Alex206/electric-kids-kart/docs/11_measurements_needed.md

# 11 — Measurements required before fabrication

Fill in every `TBD` field.

## Existing wheels

| Measurement | Front left | Front right | Rear left | Rear right |
|---|---:|---:|---:|---:|
| Outside diameter, mm | TBD | TBD | TBD | TBD |
| Width, mm | TBD | TBD | TBD | TBD |
| Hub bore / bearing ID, mm | TBD | TBD | TBD | TBD |
| Bolt circle and stud count | TBD | TBD | TBD | TBD |
| Offset from hub face, mm | TBD | TBD | TBD | TBD |
| Load/speed marking | TBD | TBD | TBD | TBD |

Photograph both sides of every wheel with a ruler in frame.

## Existing steel

| Field | Value |
|---|---|
| Profile shape | TBD |
| Outside dimensions | TBD |
| Wall thickness | TBD |
| Length and quantity | TBD |
| Material/grade if known | TBD |
| Rust, dents or prior welds | TBD |

## Driver fit

Measure seated in the intended kart posture, wearing shoes and helmet.

| Measurement | 5-year-old | 13-year-old | Adult tester |
|---|---:|---:|---:|
| Mass, kg | TBD | TBD | TBD |
| Hip-to-heel, mm | TBD | TBD | TBD |
| Hip-to-steering-wheel reach, mm | TBD | TBD | TBD |
| Shoulder height above seat, mm | TBD | TBD | TBD |
| Hip width, mm | TBD | TBD | TBD |

## Site

- Usable straight-line test distance: TBD m.
- Surface: TBD.
- Maximum gradient: TBD %.
- Minimum turning-area width: TBD m.
- Storage temperature range: TBD.

## Component interfaces after purchase

- Axle length and keyway: TBD.
- Hub bolt pattern: TBD.
- Brake disc diameter/thickness/bolt circle: TBD.
- Spindle kingpin diameter and steering arm thread: TBD.
- Motor shaft/sprocket dimensions: TBD.
- Battery exact dimensions, mass and connector: TBD.
