Alex206/electric-kids-kart/CHANGELOG.md

# Changelog

## 0.1.0 — 2026-08-01

- Initial requirements, safety concept and architecture.
- Parametric frame model and preliminary drawings.
- Two-stage MY1020D drivetrain calculation.
- BOM and current price references for Germany/EU.
- VESC and Kelly commissioning baselines.
