Alex206/electric-kids-kart/(commit log)

2026-08-02 Add VESC controller baseline
2026-08-02 Add parametric frame model
    [frame.scad]
2026-08-02 Add complete bill of materials
    [bom.csv]
2026-08-02 Add frame design
2026-08-02 Add steering design
2026-08-02 Add drivetrain design
2026-08-02 Add editable frame drawing
2026-08-02 Add editable steering drawing
2026-08-02 Add editable electrical schematic
